JBlitzar/flsh/planning/bms/README.md

Buy an off the shelf BMS, like https://renewspark.com/products/2s-10a-bms-hx-2s-d20

Buy some 21700s, can buy unprotected
