JBlitzar/flsh/planning/v4/README.md

C73346

XL6006
XLSEMI (Shanghai Xinlong Semiconductor Technology Co., Ltd.) 

https://www.lcsc.com/datasheet/C73346.pdf

Image

AI says:

Current sense: 0.22 Ω, 1%, 0.5 W resistor: found C49164922

Inductor: 47 µH, rated for at least 5 A, following the datasheet's reference design. Found C497913

Rectifier: Schottky diode rated for at least 60 V and appropriate current; the exact choice needs thermal verification.

Output capacitor: 63 V rated, low-ESR, with adequate ripple-current rating.

Protection: Add the datasheet's LED-open overvoltage circuit, rather than relying on the chip's switching-current limit.
