JBlitzar/flsh/planning/v1/README.md

https://www.lcsc.com/product-detail/C9404.html

source 21700 at least 30A from liionwholesale.com or batteryhookup.com

https://webench.ti.com/power-designer/switching-regulator/select
Input: DC 3.2 V - 4 VOutput: 28 V at 1.1 ATemp: 30 °C

need 2oz copper

C3029011 as a potential alternative inductor

TODO on the bulk caps:
 - if i need them
 - if I really need two on each VIN and IOUT or one on one and two on the other or what
 - if I can put them on another board
 - voltage rating of 25V for my 25-28V power supply is sketchy; Consider C2836436 as an alternative?

 I DO need them. I DO need both

other potential inductor options:

C49237944
C50326298
C49261537
C5378575

Which traces need to be thick? Which traces can't be via'd down to B.cu, and then via'd back up to F.cu?
