JBlitzar/flsh/blend/render1.png

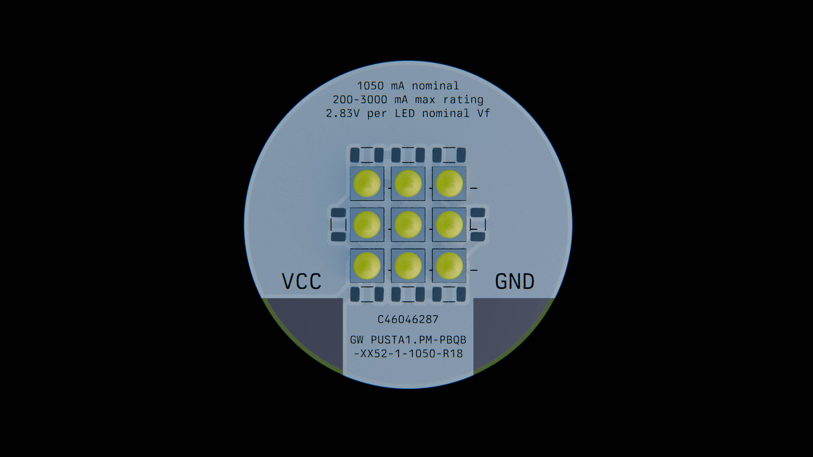
blend/render1.png
