JBlitzar/flsh/planning/v4/Screenshot 2026-10-11 at 15.16.50.png

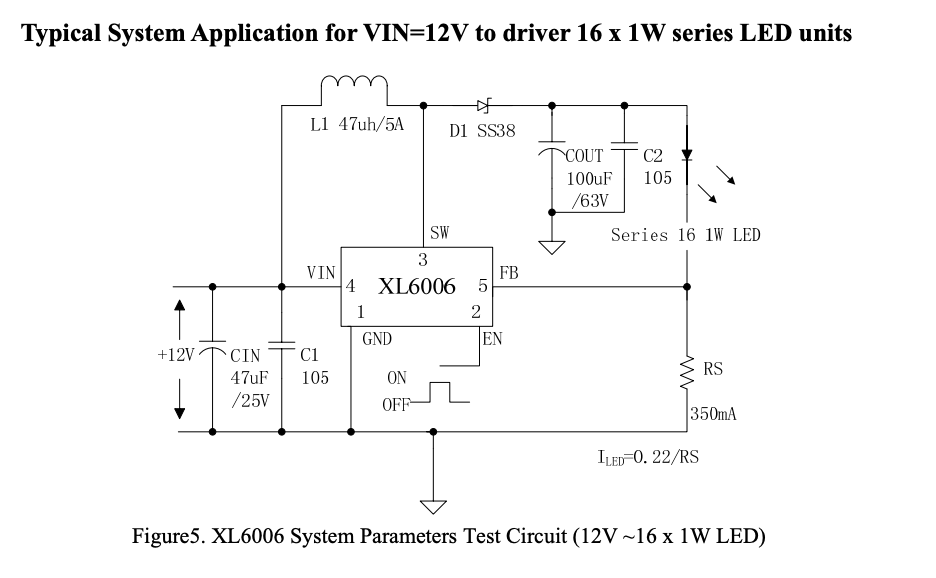
planning/v4/Screenshot 2026-10-11 at 15.16.50.png
