JBlitzar/flsh/PCB/flsh/production/flsh_batt/flsh_batt_v1_bom.csv

Designator | Footprint | Quantity | Value | LCSC Part #
BT1, BT2 | BAT_1121 | 2 | 1121
TP1, TP2, TP3 | TestPoint_Pad_D4.0mm | 3 | TestPoint
