JBlitzar/flsh/PCB/flsh/production/flsh_boost/flsh_boost_v1_bom.csv

Designator | Footprint | Quantity | Value | LCSC Part #
C1 | 2220 | 1 | 47uF 35V | C27840590
C2 | CAP-SMD_BD10.0-L10.3-W10.3-FD | 1 | 100uF 63V | C53120969
C3, C4 | 1206 | 2 | 1uF | C13832
D1 | D_SMA | 1 | SS38_C64999 | C64999
DZ1 | D_SOD-123F | 1 | ZENER | C49023525
L1 | IND-SMD_L13.8-W12.6_H6.5 | 1 | YSPI1365-470M | C497913
R1 | 1206 | 1 | 2kΩ | C133543
RS1 | 2512 | 1 | JER2512F2R220 | C49164922
TP1, TP2, TP3, TP4, TP5_EN1 | TestPoint_Pad_D4.0mm | 5 | TestPoint
U2 | TO-263-5_L10.2-W9.9-P1.70-LS14.4-TL | 1 | XL6006E1 | C73346
