JBlitzar/flsh/PCB/flsh/production/flsh_led/flsh_led_v1.1_bom.csv

Designator | Footprint | Quantity | Value | LCSC Part #
C1, C2, C3, C4, C5, C6, C7, C8 | 1206 | 8 | C_US
LED1, LED2, LED3, LED4, LED5, LED6, LED7, LED8, LED9 | LED-SMD_3P-L3.7-W3.7_GW-PUSTA1.PM-NAPD-XX510-1-1050-R18 | 9 | GW PUSTA1.PM-PBQB-XX52-1-1050-R18 | C46046287
TP1, TP2 | TestPoint_Pad_D1.0mm | 2 | TestPoint
