JBlitzar/flsh/PCB/flsh/Keystone_1121.step

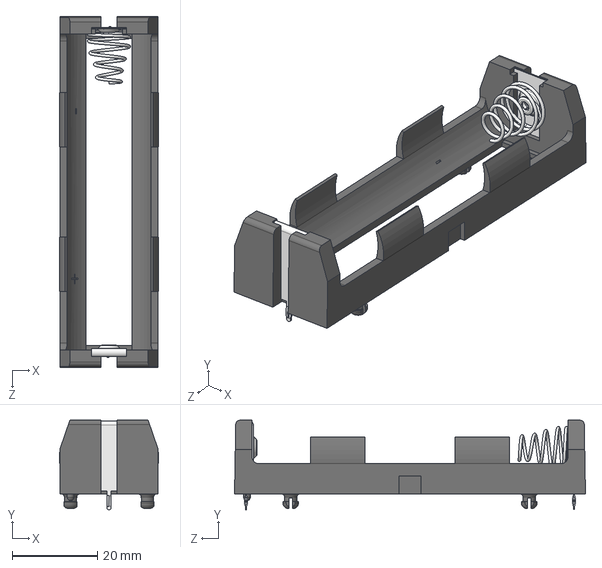
[picture p7: CAD file, 2026-10-13]
PCB/flsh/Keystone_1121.step
23.3 x 21.0 x 82.2 mm
