JBlitzar/flsh/PCB/flsh/LED_GW_CSHPM1.stp

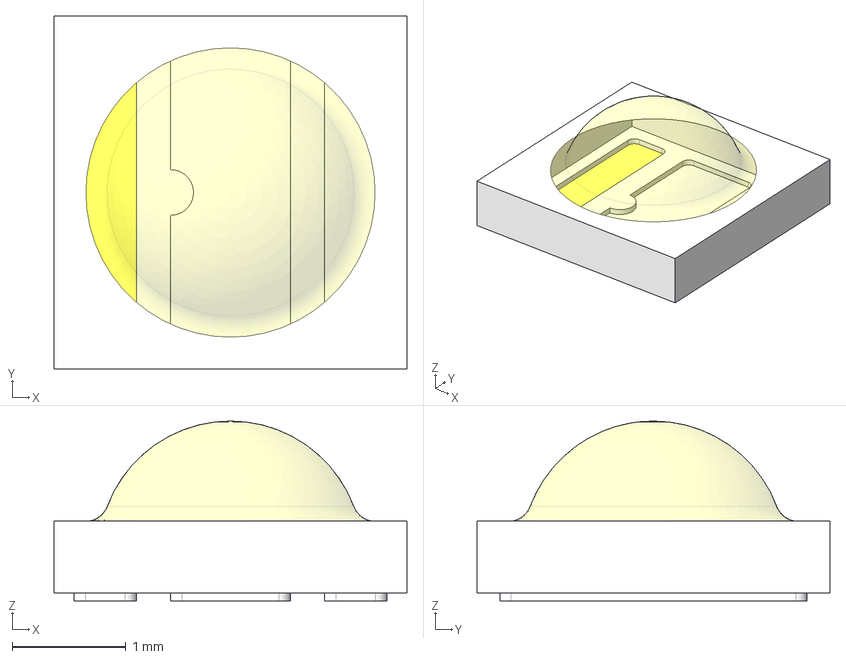
[picture p8: CAD file, 2026-10-04]
PCB/flsh/LED_GW_CSHPM1.stp
3.10 x 3.10 x 1.58 mm
