JBlitzar/flsh/(list of files, cad)

Other CAD files:
blend/flsh.blend
