JBlitzar/flsh/PCB/flsh/flsh.kicad_pcb

## KiCad design PCB/flsh/flsh.kicad_pcb (2026-10-25)

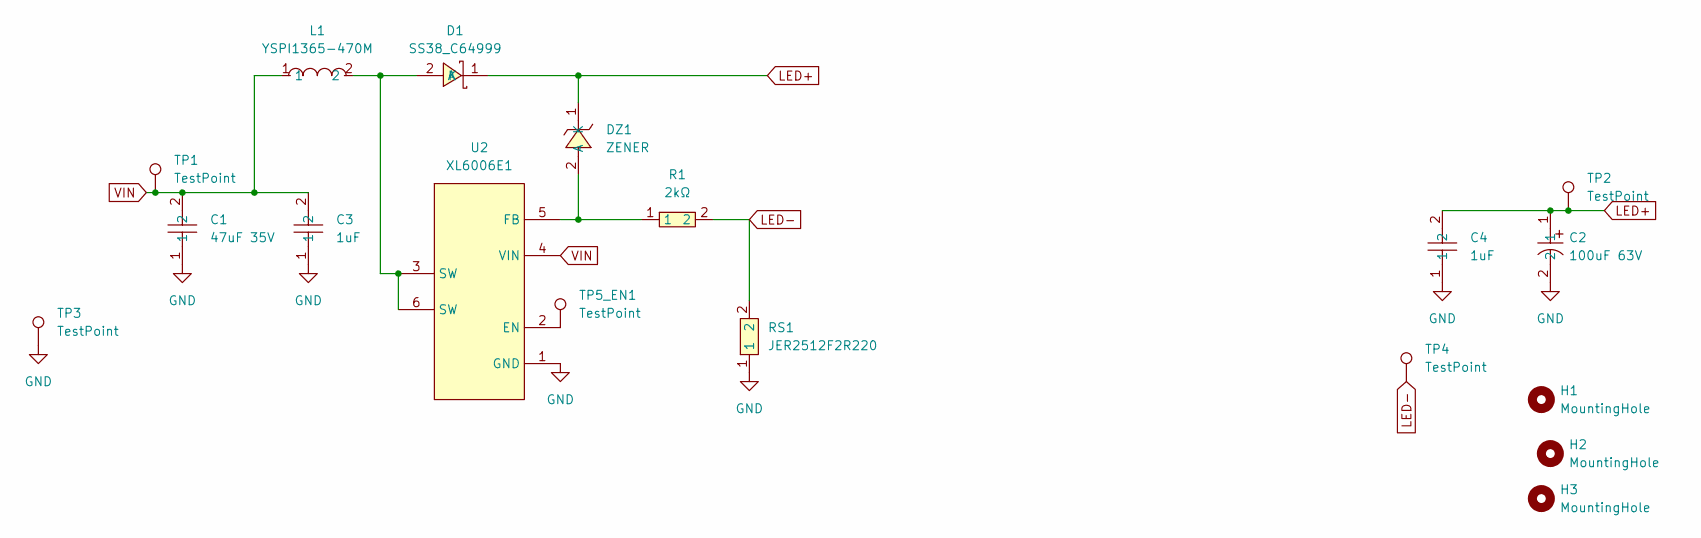
[picture p9: schematic flsh.kicad_sch]

Parts:
C1: 47uF 35V; C_2220_5750Metric; MPN KTJ350B476M55BFT00; LCSC Part C27840590
C2: 100uF 63V; CAP-SMD_BD10.0-L10.3-W10.3-FD; MPN MA80V100M10X12; LCSC Part C53120969
C3, C4: 1uF; C_1206_3216Metric; MPN CL31B105KCHNNNE; LCSC Part C13832
D1: SS38_C64999; D_SMA; MPN SS38; LCSC Part C64999
DZ1: ZENER; D_SOD-123F; MPN BZT52C39 WT; LCSC Part C49023525
H1, H2, H3: MountingHole; MountingHole_3.2mm_M3
L1: YSPI1365-470M; IND-SMD_L13.8-W12.6_H6.5; MPN YSPI1365-470M; LCSC Part C497913
R1: 2kΩ; R_1206_3216Metric; MPN RC1206FR-072KL; LCSC Part C133543
RS1: JER2512F2R220; R_2512_6332Metric; MPN JER2512F2R220; LCSC Part C49164922
TP1, TP2, TP3, TP4, TP5_EN1: TestPoint; TestPoint_Pad_D4.0mm
U2: XL6006E1; TO-263-5_L10.2-W9.9-P1.70-LS14.4-TL; MPN XL6006E1; LCSC Part C73346

Connections:
GND: C1.1, C2.2, C3.1, C4.1, RS1.1, TP3.1 (1_1), U2.1 (GND)
LED+: C2.1, C4.2, D1.1 (K), DZ1.1 (K), TP2.1 (1_1)
LED-: R1.2, RS1.2, TP4.1 (1_1)
unnamed: D1.2 (A), L1.2, U2.3 (SW), U2.6 (SW)
unnamed: DZ1.2 (A), R1.1, U2.5 (FB)
unnamed: TP5_EN1.1 (1_1), U2.2 (EN)
VIN: C1.2, C3.2, L1.1, TP1.1 (1_1), U2.4 (VIN)

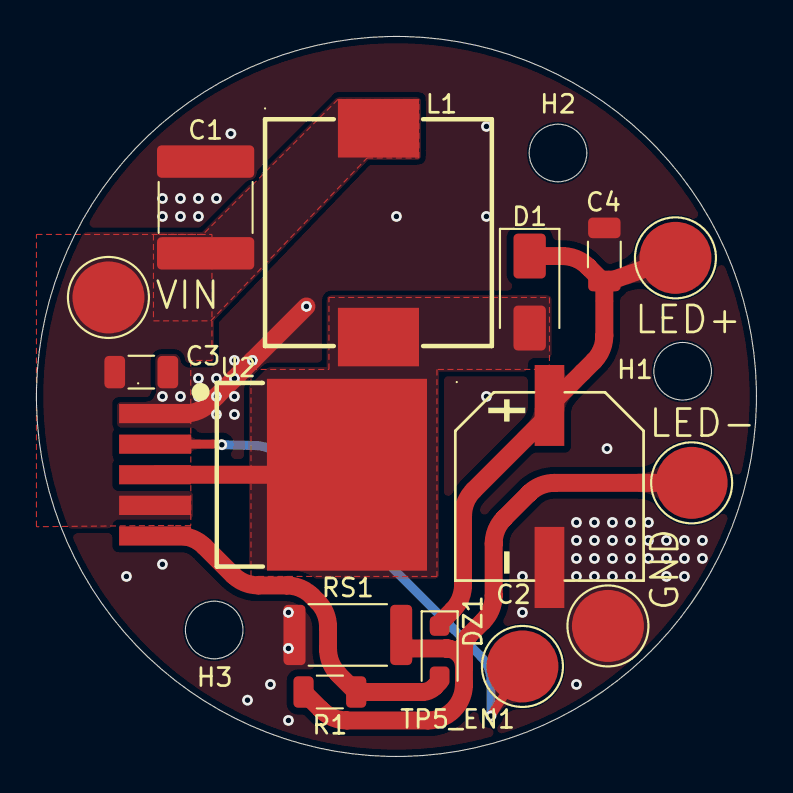
[picture p10: board flsh.kicad_pcb from above]

Board: 2 copper layers, 40.0 x 40.0 mm, 19 parts (1 on the bottom side), 7 nets.

Other parts of the board:
kobee-studio-6ADE59CA: Kobee Studio; kobee-studio-6ADE59CA
