JBlitzar/flsh/PCB/flsh/flsh_led.kicad_pcb

## KiCad design PCB/flsh/flsh_led.kicad_pcb (2026-10-25)

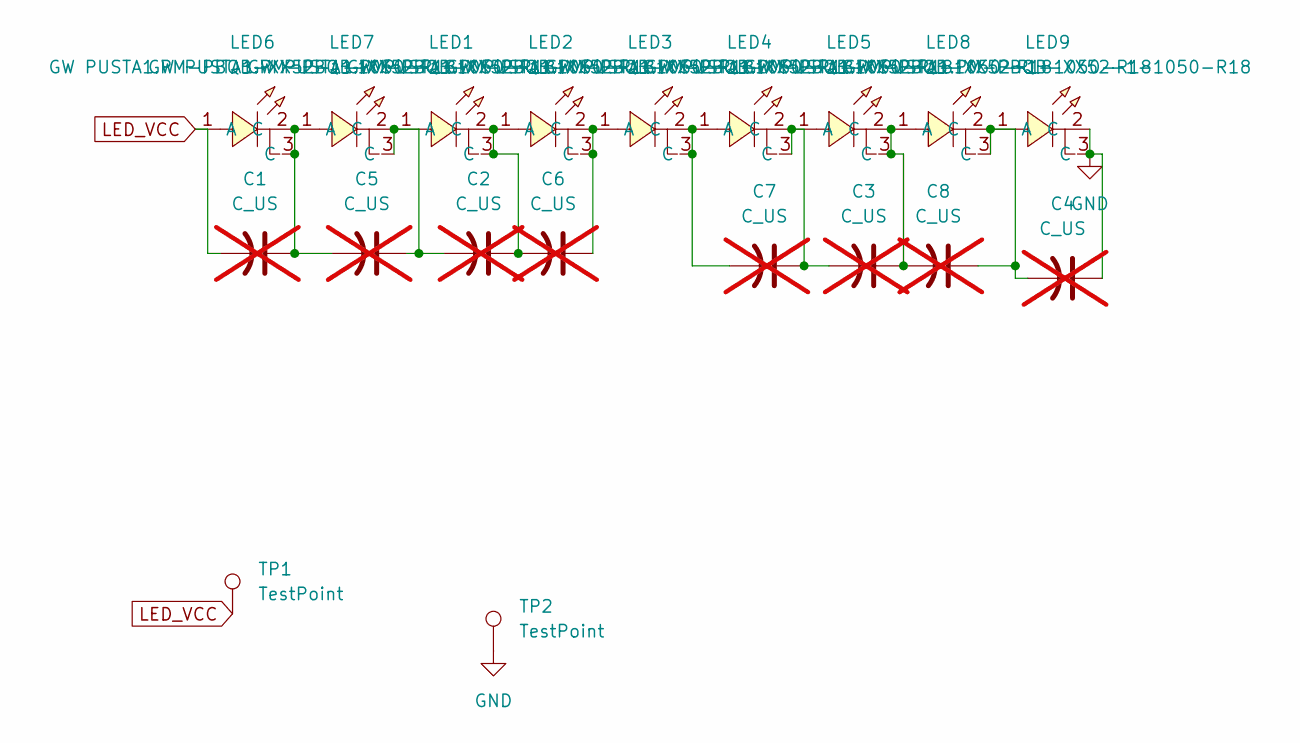
[picture p11: schematic flsh_led.kicad_sch]

Parts:
C1, C2, C3, C4, C5, C6, C7, C8: C_US; C_1206_3216Metric; not fitted
LED1, LED2, LED3, LED4, LED5, LED6, LED7, LED8, LED9: GW PUSTA1.PM-PBQB-XX52-1-1050-R18; LED-SMD_3P-L3.7-W3.7_GW-PUSTA1.PM-NAPD-XX510-1-1050-R18; MPN GW PUSTA1.PM-PBQB-XX52-1-1050-R18; LCSC Part C46046287
TP1, TP2: TestPoint; TestPoint_Pad_D1.0mm

Connections:
GND: C4.1, LED9.2 (C), LED9.3 (C), TP2.1 (1_1)
LED_VCC: C1.2, LED6.1 (A), TP1.1 (1_1)
unnamed: C2.2, C5.1, LED1.1 (A), LED7.2 (C), LED7.3 (C)
unnamed: C2.1, C6.2, LED1.2 (C), LED1.3 (C), LED2.1 (A)
unnamed: C6.1, LED2.2 (C), LED2.3 (C), LED3.1 (A)
unnamed: C7.2, LED3.2 (C), LED3.3 (C), LED4.1 (A)
unnamed: C3.2, C7.1, LED4.2 (C), LED4.3 (C), LED5.1 (A)
unnamed: C1.1, C5.2, LED6.2 (C), LED6.3 (C), LED7.1 (A)
unnamed: C3.1, C8.2, LED5.2 (C), LED5.3 (C), LED8.1 (A)
unnamed: C4.2, C8.1, LED8.2 (C), LED8.3 (C), LED9.1 (A)

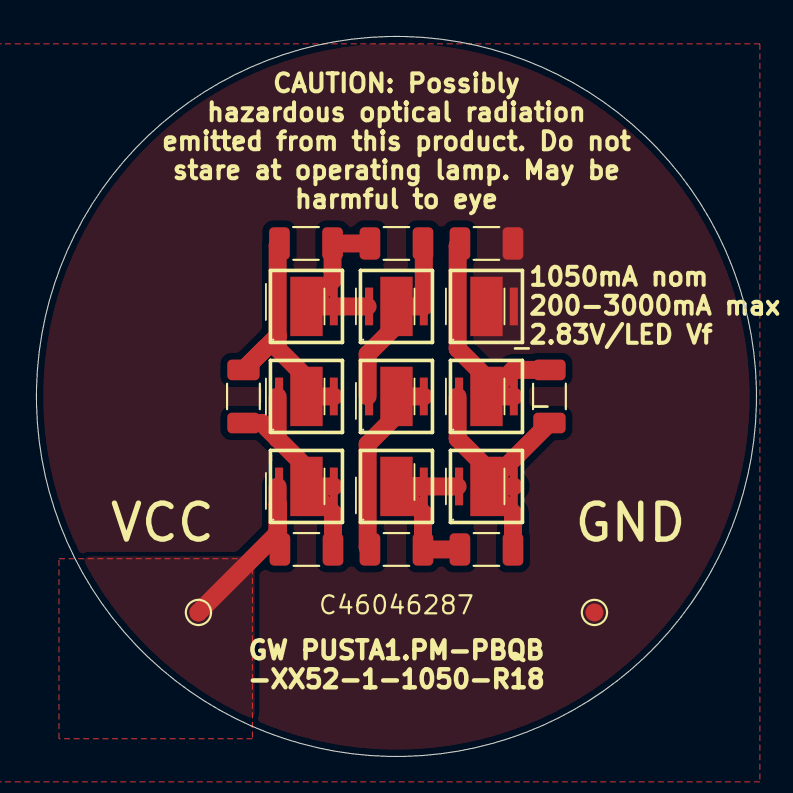
[picture p12: board flsh_led.kicad_pcb from above]

Board: 2 copper layers, 40.0 x 40.0 mm, 19 parts (0 on the bottom side), 10 nets.
