JBlitzar/flsh/PCB/flsh/flsh_batt.kicad_pcb

## KiCad design PCB/flsh/flsh_batt.kicad_pcb (2026-10-15)

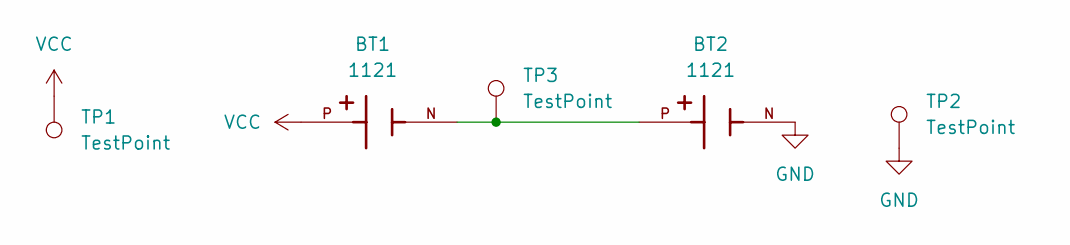
[picture p13: schematic flsh_batt.kicad_sch]

Parts:
BT1, BT2: 1121; BAT_1121; PARTREV A
TP1, TP2, TP3: TestPoint; TestPoint_Pad_D4.0mm

Connections:
GND: BT2.N, TP2.1 (1_1)
unnamed: BT1.N, BT2.P, TP3.1 (1_1)
VCC: BT1.P, TP1.1 (1_1)

Board: 2 copper layers, 5 parts (0 on the bottom side), 3 nets, no tracks yet.
