JBlitzar/flsh/(commit log)

2026-10-08 planning the power management!
    [WBBOMDesignLM3478MM_NOPB.csv]
2026-10-08 operation copy TI step 1
    [flsh.kicad_sch, flsh_led.kicad_pcb, flsh_led.kicad_sch]
2026-10-08 more layout
    [flsh.kicad_pcb, flsh.kicad_sch]
2026-10-09 various pcb improvements and musings
    [flsh.kicad_pcb]
2026-10-12 lwk redid the whole pcb
    [flsh.kicad_pcb, flsh.kicad_sch]
2026-10-12 planning v1 to v4
    [WBBOMDesignLM3478MM_NOPB (1).csv]
2026-10-12 tiny changes
    [flsh.kicad_pcb]
2026-10-12 incremental small + cosmetic changes
    It looks so pretty now
    I also know that I'm distracting myself and I should do something else now
    [flsh.kicad_pcb, flsh.kicad_sch]
2026-10-13 render2 !
    [flsh.blend, flsh.kicad_pcb]
2026-10-13 flsh batt!
    [Keystone_1121.step, flsh_batt.kicad_pcb, flsh_batt.kicad_sch, flsh_batt_v1_bom.csv, flsh_batt_v1_designators.csv, flsh_batt_v1_positions.csv]
2026-10-24 clean up tracks and vias
    [flsh_led.kicad_pcb]
